kdchen2/ECE445-Auto-Adjusting-Lamp-zl114-kdchen2-jihyun4/(commit log)

2025-12-10 Create Data filtering algorithm arbitrary data log 1
2025-12-10 Create Data filtering algorithm arbitrary data log 2
2025-12-10 Update kdchen2_journal.md
    complete lab notebook
    -updates were made locally on personal device in the past
    -due to this not being my default github account, I did not commit at time of documentation
